hienhien61/EXTENSION-BOARD-DE10-NANO/README.md

# EXTENSION-BOARD-DE10-NANO
This is a I/O extension board for DE10 Nano includes LEDs, switches, buttons, LCD,...
The project contains:
- Schematic and simulate in Proteus
- Schematic and PCB layout in Altium 
- Pin Assignment of Extension Board (40x2 GPIO)
- Proposal and Slide PPT of project
