hienhien61/EXTENSION-BOARD-DE10-NANO/(list of files, drawings)

Other design files:
Altium/7seg.SchDoc
Altium/button.SchDoc
Altium/buzzer.SchDoc
Altium/de10nano.PcbDoc
Altium/de10nano.PrjPcb
Altium/gpio.SchDoc
Altium/lcd.SchDoc
Altium/led.SchDoc
Altium/matrix.SchDoc
Altium/switch.SchDoc
Proteus/de10nano.pdsprj
Proteus/temp.pdsprj
