hienhien61/EXTENSION-BOARD-DE10-NANO/(commit log)

2022-06-24 Extension Board add
    [7seg.SchDoc, PCB1.PcbDoc, de10nano.pdsprj, gpio.SchDoc, led.SchDoc, switch.SchDoc, temp.pdsprj]
2022-06-24 add 2
    [7seg.SchDoc, PCB1.PcbDoc, de10nano.pdsprj, gpio.SchDoc, led.SchDoc, switch.SchDoc, temp.pdsprj]
2022-07-06 update proteus
    [de10nano.pdsprj, temp.pdsprj]
2022-07-10 update proteus and proposal
    [de10nano.pdsprj, temp.pdsprj]
2022-07-11 update proposal and proteus: led matrix, lcd, buzzer, block diagram
    [de10nano.pdsprj, temp.pdsprj]
2022-07-17 update proteus: leds
    [temp.pdsprj]
2022-07-17 update proteus: led matrix, led 7 seg
    [de10nano.pdsprj]
2022-07-24 update LCD
    [de10nano.pdsprj, temp.pdsprj]
2022-07-28 update proteus (switch, button), altium (schematic)
    [7seg.SchDoc, PCB1.PcbDoc, de10nano.PrjPcb, gpio.SchDoc, led.SchDoc, temp.pdsprj]
2022-08-17 update gpio
    [7seg.SchDoc, PCB1.PcbDoc, button.SchDoc, buzzer.SchDoc, de10nano.PcbDoc, de10nano.PrjPcb, lcd.SchDoc, led.SchDoc]
2022-08-29 update altium: schematic designator
    [7seg.SchDoc, button.SchDoc, buzzer.SchDoc, gpio.SchDoc, lcd.SchDoc, led.SchDoc, matrix.SchDoc, switch.SchDoc]
2022-10-25 final design
    [PCB1.PcbDoc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]
2023-01-08 add Pin Assignment
    [Extension_Board_DE10_Nano_Pin_Assignments.xlsx]
